GrzegorzewskiSzymon/Nixie-Clock-1.1/KiCad/NixieClock2.0.kicad_pcb

## KiCad design KiCad/NixieClock2.0.kicad_pcb (2022-09-15)

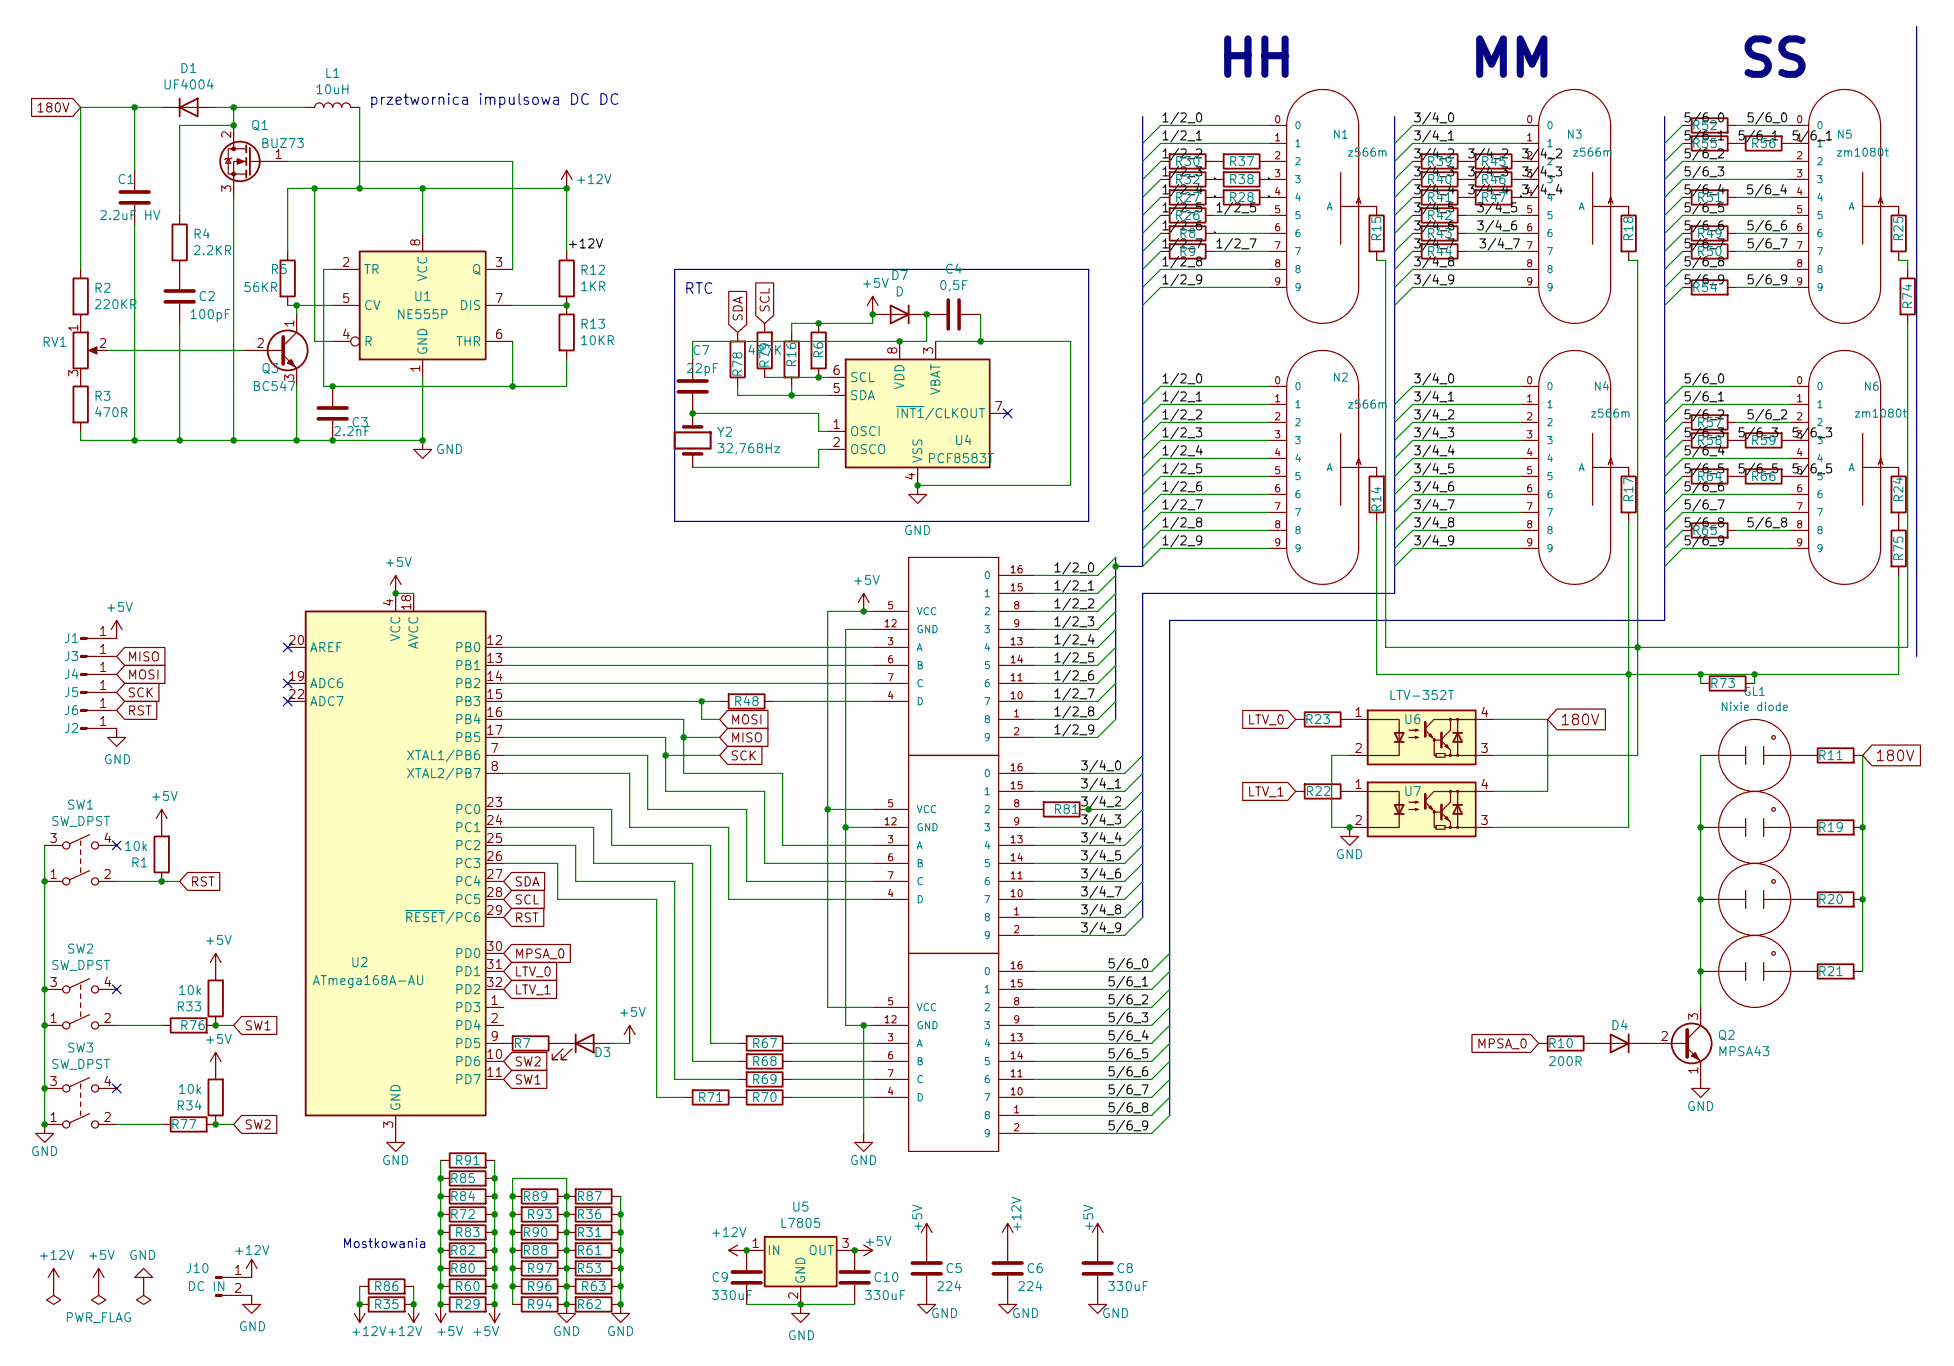
[picture p1: schematic NixieClock2.0.kicad_sch, Nixie Clock 2.0]

Parts:
C1: 2.2uF HV; CP_Radial_D8.0mm_P3.80mm
C2: 100pF; C_Disc_D5.0mm_W2.5mm_P5.00mm
C3: 2.2nF; C_Disc_D3.0mm_W2.0mm_P2.50mm
C4: 0,5F; CP_Radial_D6.3mm_P2.50mm
C5, C6: 224; C_Disc_D5.0mm_W2.5mm_P5.00mm
C7: 22pF; C_Disc_D3.0mm_W2.0mm_P2.50mm
C8, C9, C10: 330uF; CP_Radial_D5.0mm_P2.50mm
D1, D4: UF4004; D_DO-35_SOD27_P7.62mm_Horizontal
D3: LED; LED_1206_3216Metric_Pad1.42x1.75mm_HandSolder
D7: D; D_DO-34_SOD68_P7.62mm_Horizontal
GL1, GL2, GL3, GL4: Nixie diode; PinHeader_1x02_P2.54mm_Vertical
J1, J2, J3, J4, J5, J6: Conn_01x01_Male; PinHeader_1x01_P2.54mm_Vertical
J10: DC IN; BarrelJack_CUI_PJ-102AH_Horizontal
L1: 10uH; L_Axial_L6.6mm_D2.7mm_P2.54mm_Vertical_Vishay_IM-2
M1, M2, M3: 74141SOIC16; DIP-16_W7.62mm_LongPads
N1, N2, N3, N4: z566m; z566M
N5, N6: zm1080t; zm1080T
Q1: BUZ73; TO-220-3_Vertical
Q2: MPSA43; TO-92_Inline
Q3: BC547; TO-92_Inline
R1, R33, R34: 10k; R_1206_3216Metric_Pad1.30x1.75mm_HandSolder
R2: 220KR; R_1206_3216Metric_Pad1.30x1.75mm_HandSolder
R3: 470R; R_Axial_DIN0207_L6.3mm_D2.5mm_P7.62mm_Horizontal
R4: 2.2KR; R_1206_3216Metric_Pad1.30x1.75mm_HandSolder
R5: 56KR; R_1206_3216Metric_Pad1.30x1.75mm_HandSolder
R6, R16: 4R7K; R_1206_3216Metric_Pad1.30x1.75mm_HandSolder
R7: 340R; R_Axial_DIN0207_L6.3mm_D2.5mm_P7.62mm_Horizontal
R8, R9, R26, R27, R28, R29, R30, R32, R35, R37, R38, R39, R40, R41, R42, R43, R44, R45, R46, R47, R48, R49, R50, R51, R56, R57, R58, R59, R60, R63, R64, R66, R67, R68, R69, R70, R71, R74, R75, R83, R86, R91, R93, R94, R96, R97: 0R; R_1206_3216Metric_Pad1.30x1.75mm_HandSolder
R10: 200R; R_1206_3216Metric_Pad1.30x1.75mm_HandSolder
R11, R19, R20, R21: 470KR; R_1206_3216Metric_Pad1.30x1.75mm_HandSolder
R12: 1KR; R_1206_3216Metric_Pad1.30x1.75mm_HandSolder
R13: 10KR; R_1206_3216Metric_Pad1.30x1.75mm_HandSolder
R14, R15, R17, R18: 47KR; R_Axial_DIN0207_L6.3mm_D2.5mm_P7.62mm_Horizontal
R22, R23: 340R; R_1206_3216Metric_Pad1.30x1.75mm_HandSolder
R24, R25: 56KR; R_Axial_DIN0207_L6.3mm_D2.5mm_P7.62mm_Horizontal
R31, R36, R52, R53, R54, R55, R61, R62, R65, R72, R73, R76, R77, R78, R79, R80, R81, R82, R84, R85, R87, R88, R89, R90: 0R; R_Axial_DIN0207_L6.3mm_D2.5mm_P7.62mm_Horizontal
RV1: R_POT 1K; Potentiometer_ACP_CA9-H2,5_Horizontal
SW1: SW_DPST; SW_PUSH_6mm_H4.3mm
SW2, SW3: SW_DPST; SW_PUSH-12mm
U1: NE555P; DIP-8_W7.62mm
U2: ATmega168A-AU; TQFP-32_7x7mm_P0.8mm
U4: PCF8583T; SOIC-8_7.5x5.85mm_P1.27mm
U5: L7805; DPAK-3
U6, U7: LTV-352T; SO-4_4.4x3.6mm_P2.54mm
Y2: 32,768Hz; Crystal_DS15_D1.5mm_L5.0mm_Vertical

Connections:
180V: C1.1, D1.1 (K), R2.1, R11.2, R19.2, R20.2, R21.2, U6.4, U7.4
+5V: C5.1, C8.1, C10.1, D3.2 (A), D7.2 (A), J1.1, M1.5 (VCC), M2.5 (VCC), M3.5 (VCC), R1.2, R6.1, R16.1, R29.1, R29.2, R33.2, R34.2, R60.1, R60.2, R72.1, R72.2, R80.1, R80.2, R82.1, R82.2, R83.1, R83.2, R84.1, R84.2, R85.1, R85.2, R91.1, R91.2, U2.4 (VCC), U2.6 (VCC), U2.18 (AVCC), U5.3 (OUT)
+12V: C6.1, C9.1, J10.1, L1.2, R5.1, R12.1, R35.1, R35.2, R86.1, R86.2, U1.4 (R), U1.8 (VCC), U5.1 (IN)
/1/2_0: M1.16 (0), N1.0, N2.0
/1/2_1: M1.15 (1), N1.1, N2.1
/1/2_2: M1.8 (2), N2.2, R30.2
/1/2_3: M1.9 (3), N1.3, N2.3, R32.1, R32.2, R38.1, R38.2
/1/2_4: M1.13 (4), N1.4, N2.4, R27.1, R27.2, R28.1, R28.2
/1/2_5: M1.14 (5), N1.5, N2.5, R26.1, R26.2
/1/2_6: M1.11 (6), N1.6, N2.6, R8.1, R8.2
/1/2_7: M1.10 (7), N1.7, N2.7, R9.1, R9.2
/1/2_8: M1.1 (8), N1.8, N2.8
/1/2_9: M1.2 (9), N1.9, N2.9
/3/4_0: M2.16 (0), N3.0, N4.0
/3/4_1: M2.15 (1), N3.1, N4.1
/3/4_2: N3.2, N4.2, R39.1, R39.2, R45.1, R45.2, R81.1
/3/4_3: M2.9 (3), N3.3, N4.3, R40.1, R40.2, R46.1, R46.2
/3/4_4: M2.13 (4), N3.4, N4.4, R41.1, R41.2, R47.1, R47.2
/3/4_5: M2.14 (5), N3.5, N4.5, R42.1, R42.2
/3/4_6: M2.11 (6), N3.6, N4.6, R43.1, R43.2
/3/4_7: M2.10 (7), N3.7, N4.7, R44.1, R44.2
/3/4_8: M2.1 (8), N3.8, N4.8
/3/4_9: M2.2 (9), N3.9, N4.9
/5/6_0: M3.16 (0), N5.0, N6.0, R52.1, R52.2
/5/6_1: M3.15 (1), N5.1, N6.1, R55.1, R55.2, R56.1, R56.2
/5/6_2: M3.8 (2), N5.2, N6.2, R57.1, R57.2
/5/6_3: M3.9 (3), N5.3, N6.3, R58.1, R58.2, R59.1, R59.2
/5/6_4: M3.13 (4), N5.4, N6.4, R51.1, R51.2
/5/6_5: M3.14 (5), N5.5, N6.5, R64.1, R64.2, R66.1, R66.2
/5/6_6: M3.11 (6), N5.6, N6.6, R49.1, R49.2
/5/6_7: M3.10 (7), N5.7, N6.7, R50.1, R50.2
/5/6_8: M3.1 (8), N5.8, N6.8, R65.1, R65.2
/5/6_9: M3.2 (9), N5.9, N6.9, R54.1, R54.2
GND: C1.2, C2.2, C3.2, C4.2, C5.2, C6.2, C8.2, C9.2, C10.2, J2.1, J10.2, M1.12 (GND), M2.12 (GND), M3.12 (GND), Q1.3 (S), Q2.1 (E), Q3.3 (E), R3.2, R31.1, R31.2, R36.1, R36.2, R53.1, R53.2, R61.1, R61.2, R62.1, R62.2, R63.1, R63.2, R87.1, R87.2, R88.1, R88.2, R89.1, R89.2, R90.1, R90.2, R93.1, R93.2, R94.1, R94.2, R96.1, R96.2, R97.1, R97.2, SW1.1, SW1.3, SW2.1, SW2.3, SW3.1, SW3.3, U1.1 (GND), U2.3 (GND), U2.5 (GND), U2.21 (GND), U4.3 (VBAT), U4.4 (VSS), U5.2 (GND), U6.2, U7.2
LTV_0: R23.1, U2.31 (PD1)
LTV_1: R22.2, U2.32 (PD2)
MISO: J3.1, M2.3 (A), U2.16 (PB4)
MOSI: J4.1, R48.2, U2.15 (PB3)
MPSA_0: R10.2, U2.30 (PD0)
unnamed: C2.1, R4.2
unnamed: C3.1, R13.2, U1.2 (TR), U1.6 (THR)
unnamed: C4.1, C7.2, D7.1 (K), U4.8 (VDD)
unnamed: C7.1, U4.1 (OSCI), Y2.1
unnamed: D1.2 (A), L1.1, Q1.2 (D), R4.1
unnamed: D3.1 (K), R7.1
unnamed: D4.1 (K), Q2.2 (B)
unnamed: D4.2 (A), R10.1
unnamed: GL1.1 (A), GL2.1 (A), GL3.1 (A), GL4.1 (A), Q2.3 (C)
unnamed: GL1.2 (A1), R11.1
unnamed: GL2.2 (A1), R19.1
unnamed: GL3.2 (A1), R20.1
unnamed: GL4.2 (A1), R21.1
unnamed: M1.3 (A), U2.12 (PB0)
unnamed: M1.4 (D), R48.1
unnamed: M1.6 (B), U2.13 (PB1)
unnamed: M1.7 (C), U2.14 (PB2)
unnamed: M2.4 (D), U2.8 (XTAL2/PB7)
unnamed: M2.7 (C), U2.7 (XTAL1/PB6)
unnamed: M2.8 (2), R81.2
unnamed: M3.3 (A), R67.1
unnamed: M3.4 (D), R70.1
unnamed: M3.6 (B), R68.1
unnamed: M3.7 (C), R69.1
unnamed: N1.2, R37.1
unnamed: N1.A, R15.1
unnamed: N2.A, R14.2
unnamed: N3.A, R18.1
unnamed: N4.A, R17.1
unnamed: N5.A, R25.1
unnamed: N6.A, R24.1
unnamed: Q1.1 (G), U1.3 (Q)
unnamed: Q3.1 (C), R5.2, U1.5 (CV)
unnamed: Q3.2 (B), RV1.2
unnamed: R2.2, RV1.1
unnamed: R3.1, RV1.3
unnamed: R6.2, R79.1, U4.6 (SCL)
unnamed: R7.2, U2.9 (PD5)
unnamed: R12.2, R13.1, U1.7 (DIS)
unnamed: R14.1, R17.2, R73.1, R73.2, R75.2, U7.3
unnamed: R15.2, R18.2, R74.2, U6.3
unnamed: R16.2, R78.1, U4.5 (SDA)
unnamed: R22.1, U7.1
unnamed: R23.2, U6.1
unnamed: R24.2, R75.1
unnamed: R25.2, R74.1
unnamed: R30.1, R37.2
unnamed: R67.2, U2.23 (PC0)
unnamed: R68.2, U2.24 (PC1)
unnamed: R69.2, U2.25 (PC2)
unnamed: R70.2, R71.1
unnamed: R71.2, U2.26 (PC3)
unnamed: R76.1, SW2.2
unnamed: R77.1, SW3.2
unnamed: U4.2 (OSCO), Y2.2
RST: J6.1, R1.1, SW1.2, U2.29 (~RESET/PC6)
SCK: J5.1, M2.6 (B), U2.17 (PB5)
SCL: R79.2, U2.28 (PC5)
SDA: R78.2, U2.27 (PC4)
SW1: R33.1, R76.2, U2.11 (PD7)
SW2: R34.1, R77.2, U2.10 (PD6)

Notes on the sheet:
RTC
Mostkowania
przetwornica impulsowa DC DC

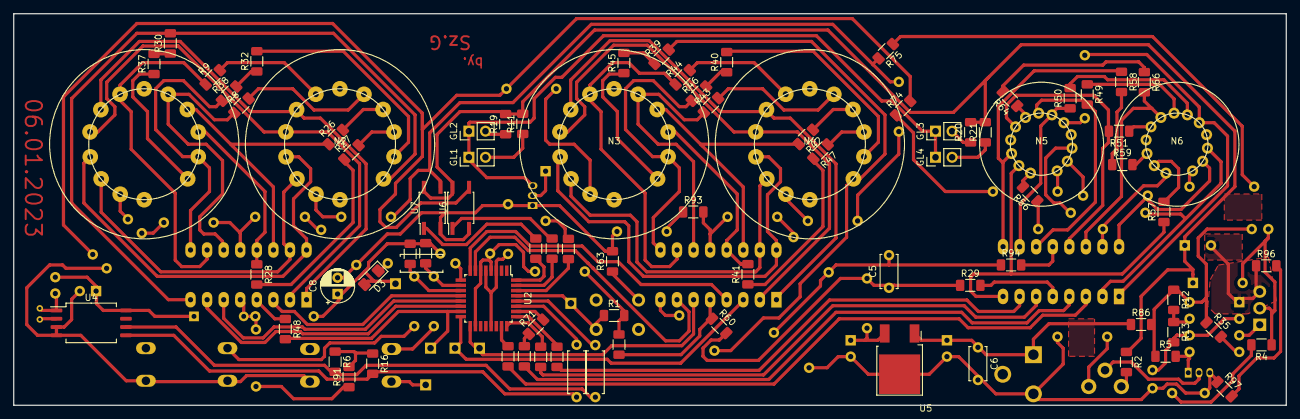
[picture p2: board NixieClock2.0.kicad_pcb from above]

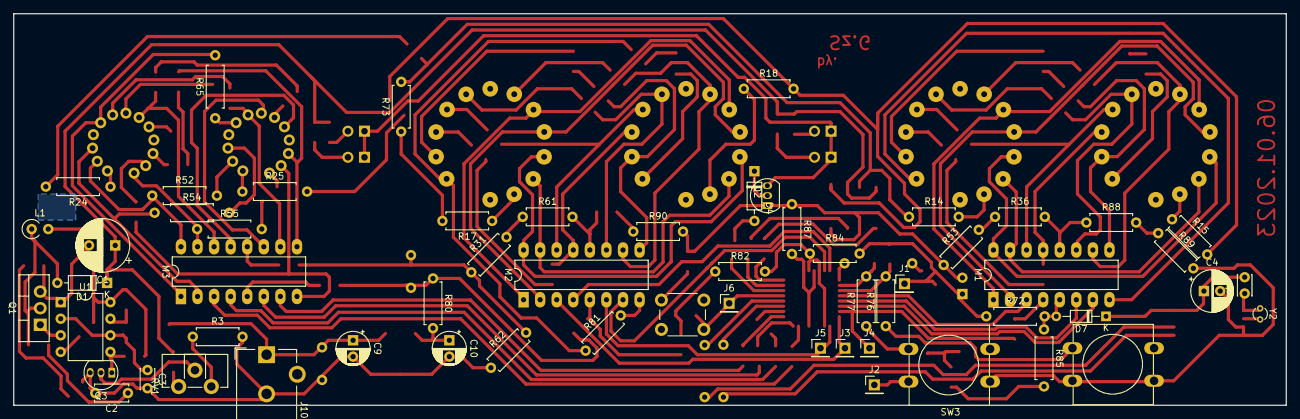
[picture p3: board NixieClock2.0.kicad_pcb from below]

Board: 2 copper layers, 195.0 x 60.0 mm, 144 parts (59 on the bottom side), 100 nets.
