GrzegorzewskiSzymon/Nixie-Clock-1.1/(commit log)

2022-06-17 add "Timer0_Init()" function to start counting milliseconds, needed for future non blocking implementations
    add "Led_Init()" and "BlinkLed()"
    add preprocessor implementations in "utils.h"
2022-06-18 add non blocking functions to count number of presses on buttons, along with fast counting after pressing button for over 2sec (can be easily change in utils.h)
2022-06-27 add function DisplayTime(h, m) to show hours and minutes on nixie tubes
2022-06-27 add preprocessor directives to turn on and off nixie tubes
2022-06-27 add hardware i2c implementations for future communication with RTC
2022-07-03 add simple directives to control nixie diodes add NixieDiodesInit() to set pins as outputs
2022-07-03 add one millisecond of turned off tubes between switching between them, because optocoupler LTV-352T switch off characteristics coused ghost digits
2022-07-03 add simple blinking of nixie diodes every 6sec
2022-07-12 add states of clock with different actions as IDLE then after setting designated hour, clock changes to SUSTAIN and wants to press a button within each 15 minutes, if not, goes to ALARMED mode and se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
2022-09-15 change pins attatchments (new schematic and pcb layout)
2022-09-15 change whole DisplayTime(...) function (caused by new schematic and pcb layout)
2022-09-15 new function for only two buttons, to insert time to RTC
2022-09-15 add schematics and one layer pcb layout
    [NixieClock2.0.kicad_pcb, NixieClock2.0.kicad_sch]
2022-12-08 add additional * seconds to the time to send to RTC, * the amount of time which the function for setting time will take from last press of a button
2022-12-08 turn off all tubes for one ms after every switch between displaying tens and units to cancel ghost numbers in tubes
2022-12-08 fix bug: inserting ms as sec to RTC in initialization
2022-12-09 add new mode of slow displaying and use it when it's time to "repair" balance in nixie tubes
